ab0tj/HardMPU/(threads)

Thread 1 (2025-02-05):

Kicad/Board Production Gerbers

oXL0C0Xo, 2025-02-05:
Good Morning,

I'm wondering if the board production files are available somewhere? I cant seem to find them, and I would love to have some of these made. I appreciate your time.

Thanks,
Bryon

ab0tj, 2025-04-17:
Hi, sorry for the late reply. I have added the Gerber files for the board described in the schematic.

Closed 2025-04-17.

Thread 2 (2025-07-01):

Possible Unauthorized Commercial Use of HardMPU

parabellum-push, 2025-07-01:
I wanted to bring to your attention that I recently came across a listing for a commercial product that appears to be based on your HardMPU project. The seller is offering it for sale and claims to have "commissioned you" for the PCB design. Given that HardMPU is licensed for free non-commercial use, I thought it might be important to verify whether this usage is authorized.

Of course, it's entirely possible that there is a legitimate arrangement in place, but I felt it was respectful to inform you just in case this claim was made without your knowledge or consent.

The listing in question : https://cafe.naver.com/cjcj/82124

parabellum-push, 2025-07-01:
Moved https://github.com/PickledDog/hardmpu-wt/issues/2

Closed 2025-07-01.
