ab0tj/HardMPU/Schematic.pdf

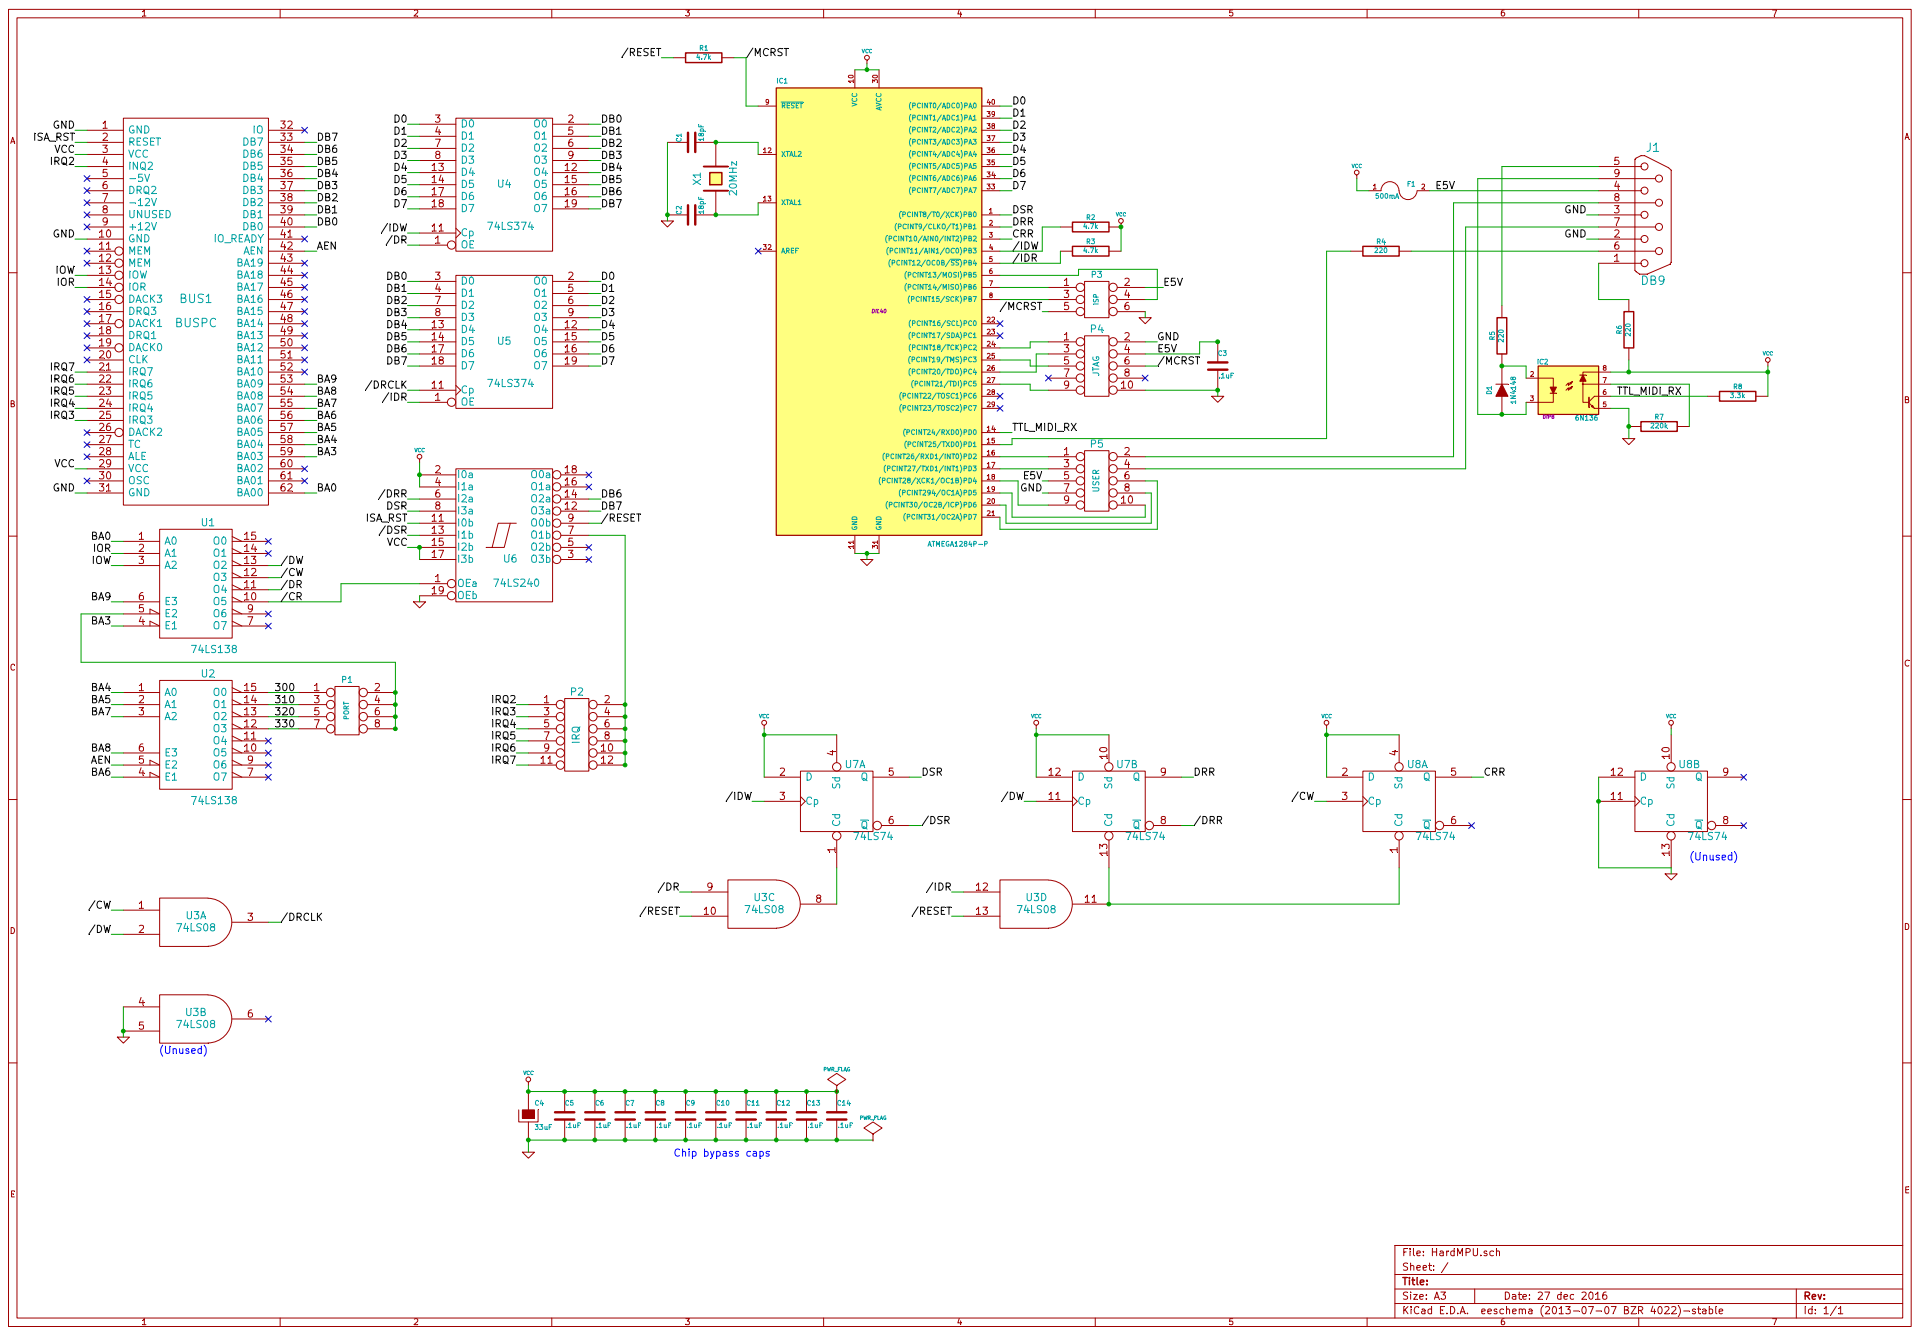
[picture p18: page 1]
