ab0tj/HardMPU/HardMPU.c

/*  Copyright (C) 2015		 ab0tj
 *
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
 *  You should have received a copy of the GNU General Public License
 *  along with this program; if not, write to the Free Software
 *  Foundation, Inc., 59 Temple Place - Suite 330, Boston, MA 02111-1307, USA.
 */

/*
 * --------------------------------------------
 * HardMPU by ab0tj - Hardware MPU-401 Emulator
 * --------------------------------------------
 * 
 * Based on SoftMPU by bjt which was
 * based on MPU401 code from DOSBox
 *
 */

#include "config.h"
#include "EXPORT.H"
#include <avr/io.h>
#include <avr/builtins.h>
#include <avr/interrupt.h>
#include <util/delay.h>

// function prototypes
void send_isa_byte(unsigned char byte);
unsigned char recv_isa_byte();
void recv_ctl_byte();

int main(void)
{
	// init GPIO
	PORTB = 0b11111000;	// bits 0-2 are driven externally
	DDRB  = 0b00011000;	// data read and data write latches
	PORTC = 0b11111111;	// pullups enabled
	PORTD = 0b11111111;	// pullups enabled
	
	// are we in the programming jig?
	if (~PINC & PIN_TEST)
	{
		DDRC = 0b01000000;	// LED pin output
		
		for (;;)	// blink the LED
		{
			PORTC &= ~PIN_LED;
			_delay_ms(125);
			PORTC |= PIN_LED;
			_delay_ms(125);
		}
	}
	
	// init UART
	UCSR0B = (1<<TXEN0);//|(1<<RXEN0);
	UCSR1B = (1<<TXEN1);
	UBRR0  = BAUD_MIDI;
	UBRR1  = BAUD_UART;
	
	// init timer
	TCCR1B |= (1<<WGM12)|(1<<CS10);	// timer1 ctc mode, no prescaler
	TIMSK1 |= (1<<OCIE1A);			// enable ctc interrupt
	OCR1A   = F_CPU / RTCFREQ - 1;	// ctc value
	
	// init emulator
	MPU401_Init();
	
	// enable interrupts
	sei();
	
    for(;;)	// main loop
    {
		// do isa i/o
		if (QueueUsed() && (~PINB & PIN_DSR)) {
			send_isa_byte(MPU401_ReadData());		// send data if there's any in the buffer
		}
		if (PINB & PIN_CRR) {		// isa control input latch is full
			MPU401_WriteCommand(recv_isa_byte());
		}
		if (PINB & PIN_DRR) {		// isa data input latch is full
			MPU401_WriteData(recv_isa_byte());
		}
		// do midi i/o
		send_midi_byte();				// see if we need to send a byte	
		/* if (UCSR0A & (1<<RXC0)) {	// midi uart rx buffer is full
			process_midi_byte();
		} */
    }
}

void send_isa_byte(Bit8u byte) {
	cli();							// disable interrupts
	DDRA = 0xff;					// set porta to output
	PORTA = byte;					// output byte on porta
	PORTB &= ~PIN_IDW;				// lower IDW
	__builtin_avr_delay_cycles(3);	// wait for logic to stabilize
	PORTB |= PIN_IDW;				// raise IDW
	DDRA = 0;						// set the port back to input
	sei();							// re-enable interrupts
}

unsigned char recv_isa_byte() {
	unsigned char temp;
	cli();							// disable interrupts
	PORTB &= ~PIN_IDR;				// lower IDR
	__builtin_avr_delay_cycles(3);	// wait for i/o to settle
	temp = PINA;					// capture what we find there
	PORTB |= PIN_IDR;				// raise IDR
	sei();							// re-enable interrupts
	return temp;					// report back with the results
}
