ab0tj/HardMPU/(commit log)

2015-09-05 Fix infinite SysEx delay.
    [MIDI.C]
2015-09-11 Disable interrupts during ISA i/o to fix stuck notes
    [EXPORT.H, HardMPU.c, MIDI.C, MPU401.C, PIC.C, config.h]
2015-09-12 Actually fix infinite SysEx delay
    [MIDI.C]
2015-09-12 Added schematic
2015-09-13 Fix corruptes SysEx transfers. Need to fix intelligent mode... Silpheed now does not work.
    [EXPORT.H, HardMPU.c, MIDI.C, MPU401.C]
2015-09-13 Fixed getting stuck in reset state. Need to investigate if this is even required.
    [MIDI.C, MPU401.C]
2015-09-13 Fixed interrupts not being enabled after an isa read.
    [HardMPU.c, MPU401.C]
2015-09-26 Don't quite config tool until reset is complete
    [MPU401.C]
2015-10-01 Fix SysEx delay for impatient games
    [HardMPU.c, MIDI.C, PIC.C]
2015-10-06 Intelligent mode fixes - Move SysEx delay to send_midi_byte function to correct timing - Re-add irq_pending code - More cleanup/8-bit optimization
    [EXPORT.H, HardMPU.c, MIDI.C, MPU401.C]
2015-10-07 Replace long 'all notes off' init step with short version Sacrifices some compatability, but saves a lot of time during init.
    [MIDI.C]
2016-12-27 Cleaned up and simplified schematic
    New schematic with added user port and less wasted logic gates. Recreated from scratch to be more readable.
2016-12-27 Remove old messy schematic
2018-04-01 Buffer fix for faster machines
    [HardMPU.c, MIDI.C, MPU401.C, PIC.C]
2018-04-22 Add test mode for prograaming jig; just blink a LED for now
2025-04-17 Added Gerbers for v1.1
